Dobbyj-r/portable-pico-8-retropie-console/3rd Jan/Jan 3rd.jpg

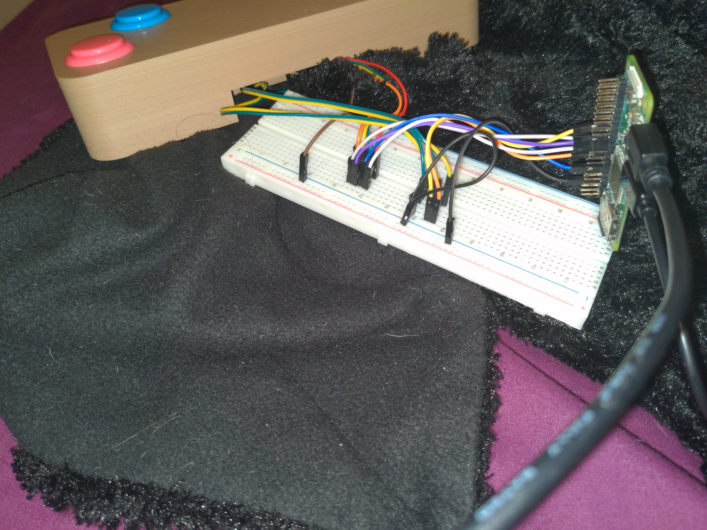
3rd Jan/Jan 3rd.jpg
