Dobbyj-r/portable-pico-8-retropie-console/4th Jan/Jan 4th.jpg

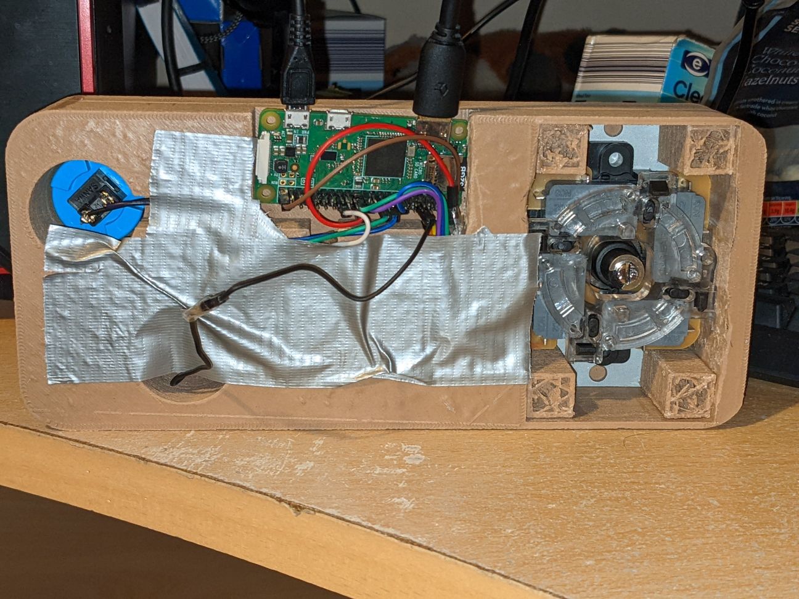
4th Jan/Jan 4th.jpg
