Dobbyj-r/portable-pico-8-retropie-console/README.md

# portable-pico-8-retropie-console
This is an idea that I had to take a pi running retropie add pico-8 to it and turn it into a portable console like a switch.

any future updates will be made on the @Dawn-Rising account
