Dobbyj-r/portable-pico-8-retropie-console/9th Jan/6 pin diagram.jpg

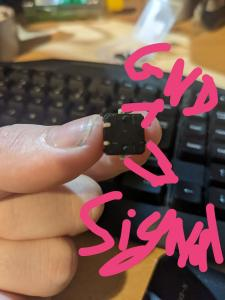
9th Jan/6 pin diagram.jpg
