Dobbyj-r/portable-pico-8-retropie-console/9th Jan/Front view.jpg

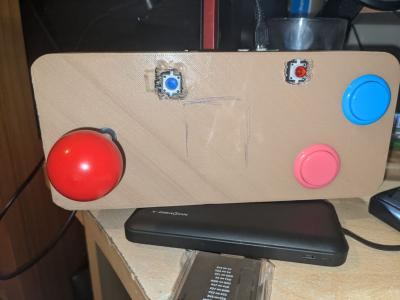
9th Jan/Front view.jpg
