Dobbyj-r/portable-pico-8-retropie-console/9th Jan/left side hole.jpg

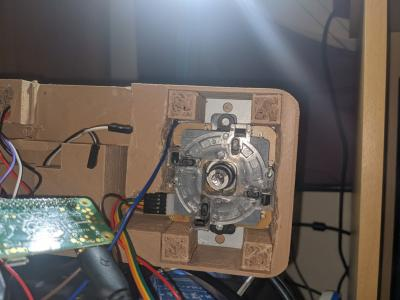
9th Jan/left side hole.jpg
