Dobbyj-r/portable-pico-8-retropie-console/9th Jan/pino out joy.png

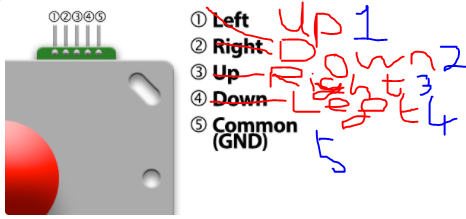
9th Jan/pino out joy.png
