Dobbyj-r/portable-pico-8-retropie-console/9th Jan/right side hole.jpg

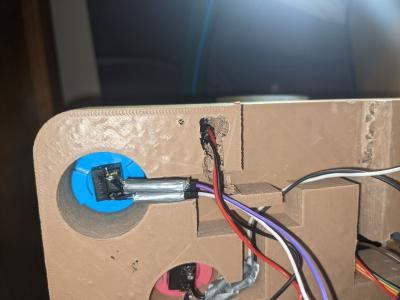
9th Jan/right side hole.jpg
