Dobbyj-r/portable-pico-8-retropie-console/31 Dec/Dec 31st under-side.jpg

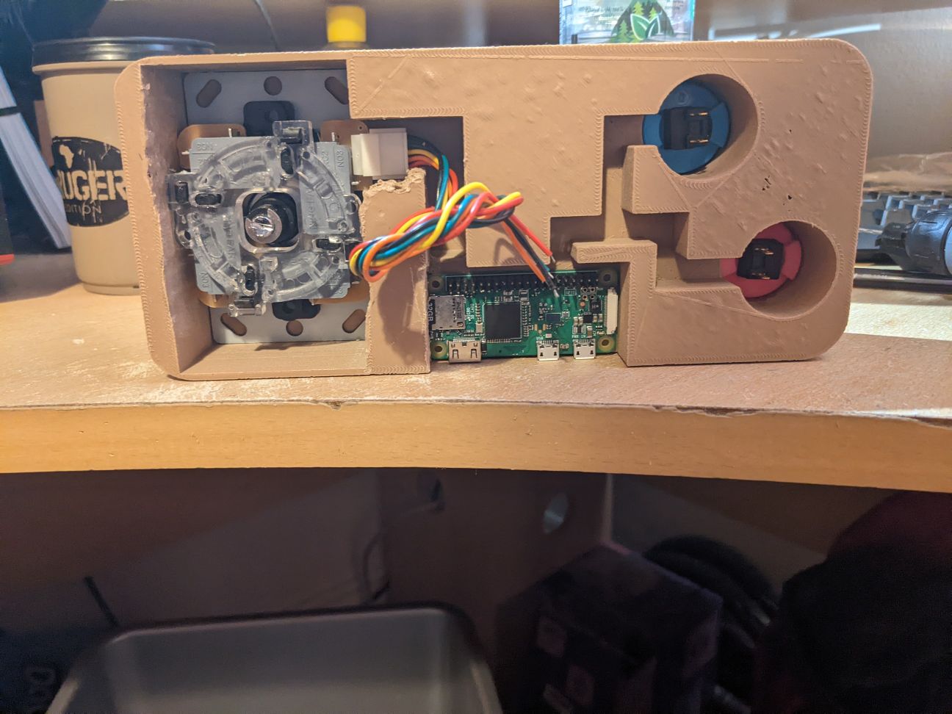
31 Dec/Dec 31st under-side.jpg
