Dobbyj-r/portable-pico-8-retropie-console/9th Jan/Unnamed-Cube.stl

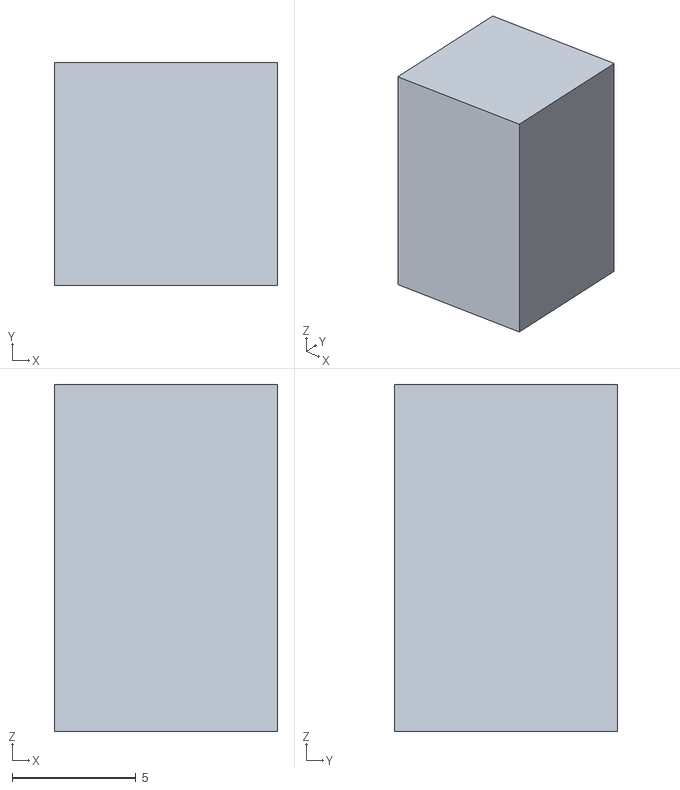
[picture p10: CAD file, 2022-01-09]
9th Jan/Unnamed-Cube.stl
9.00 x 9.00 x 14.0
